rtjelum/m5dail_little_engineer/3d_models/renders/DeskBase.png

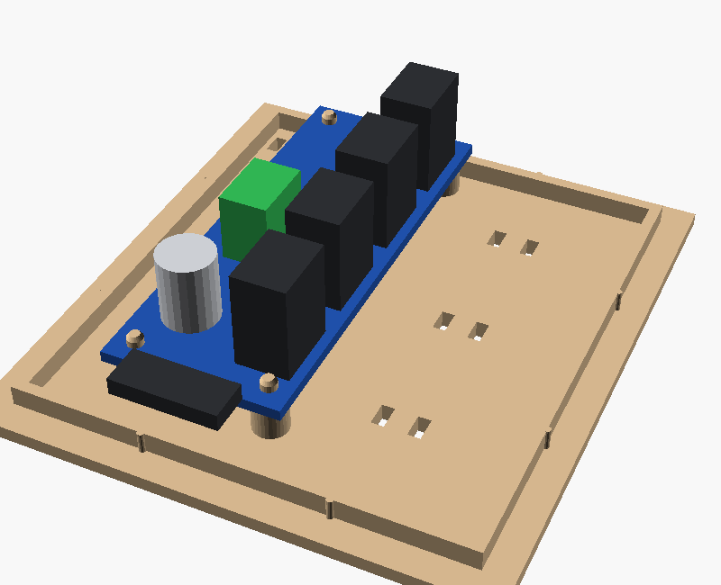
3d_models/renders/DeskBase.png
