rtjelum/m5dail_little_engineer/3d_models/renders/RobotScene_cutaway.png

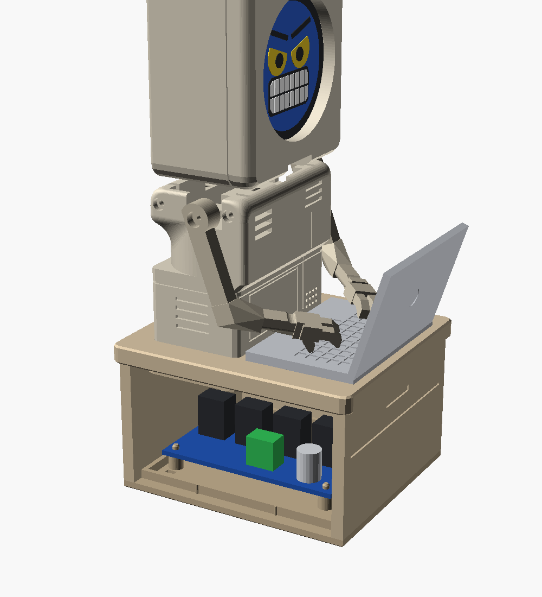
3d_models/renders/RobotScene_cutaway.png
