rtjelum/m5dail_little_engineer/3d_models/renders/RobotScene_side.png

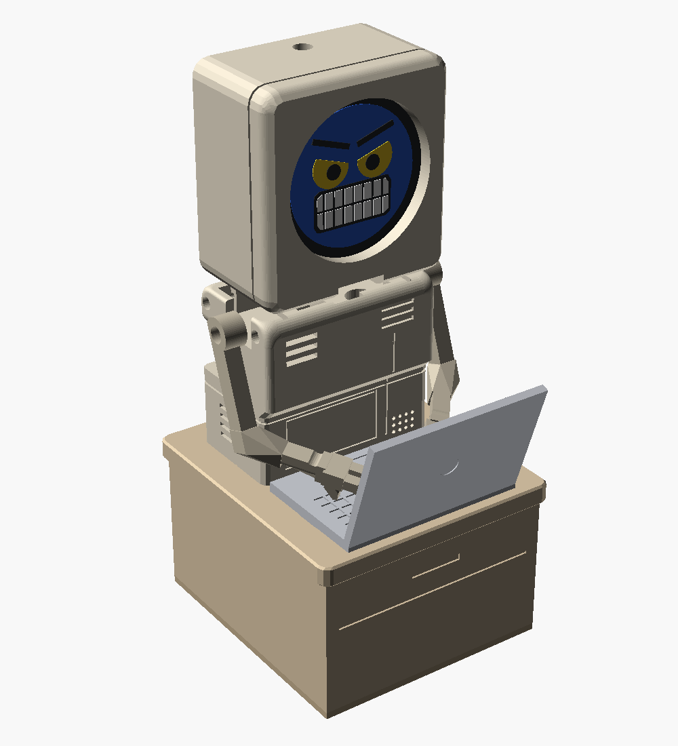
3d_models/renders/RobotScene_side.png
