rtjelum/m5dail_little_engineer/circular_maze.png

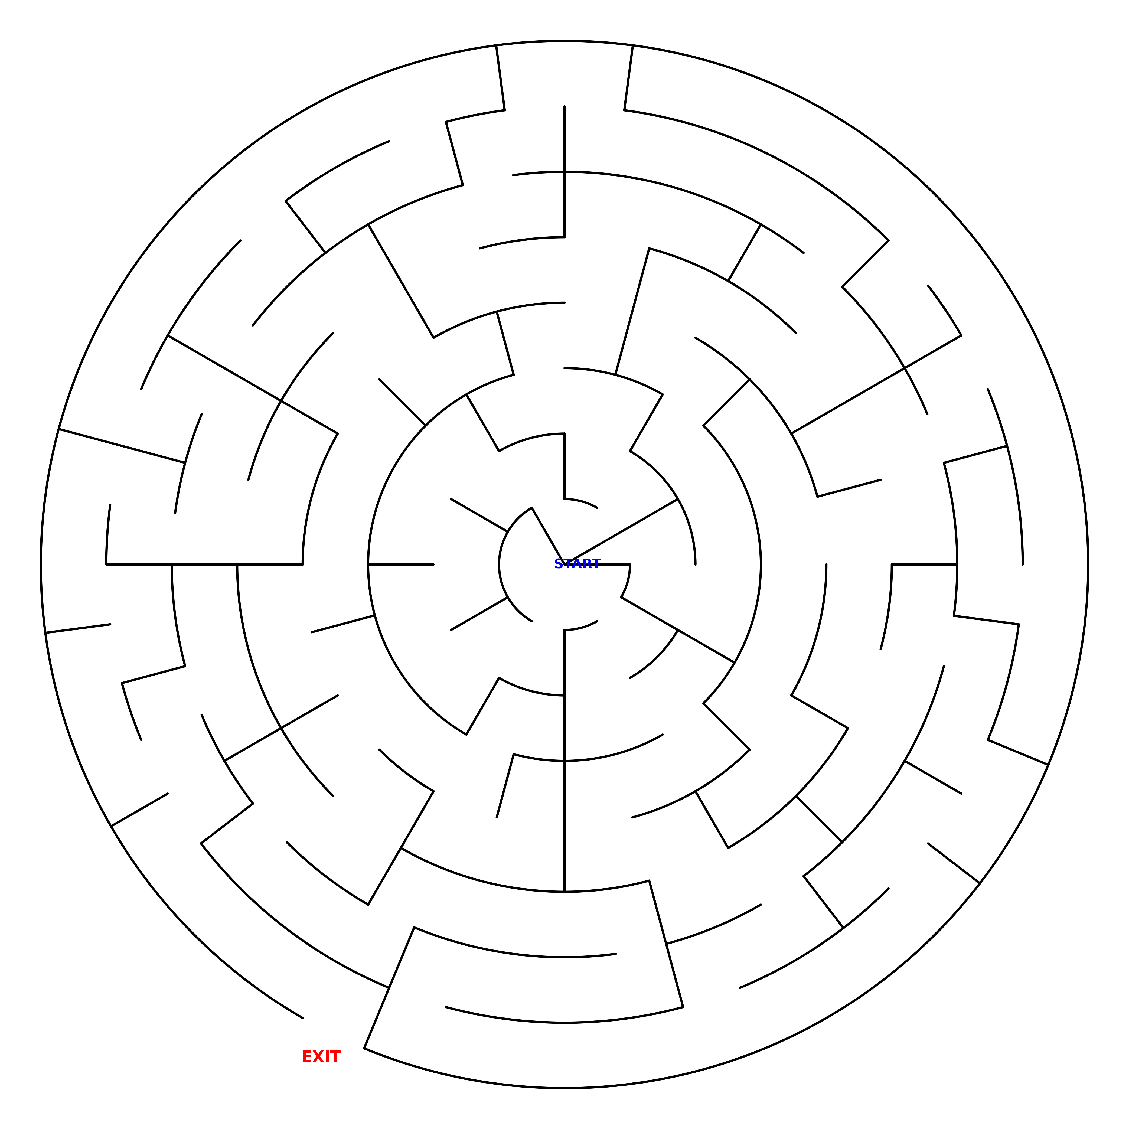
circular_maze.png
