rtjelum/m5dail_little_engineer/3d_models/openscad/base/es9051/LampCap.stl

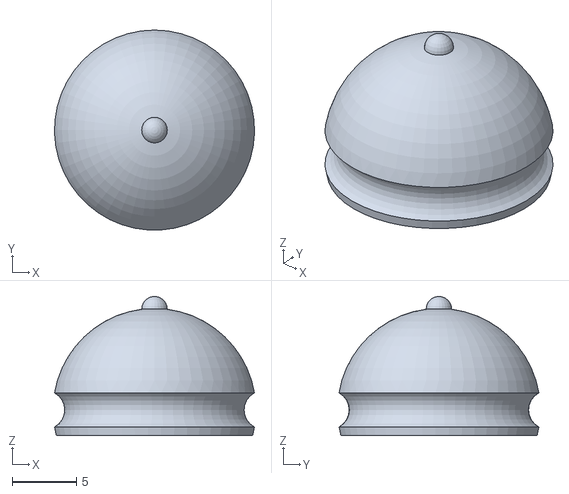
[picture p9: CAD file, 2026-11-06]
3d_models/openscad/base/es9051/LampCap.stl
15.6 x 15.6 x 10.9
