rtjelum/m5dail_little_engineer/3d_models/parts/gh-s37d/stl/DeskBox.stl

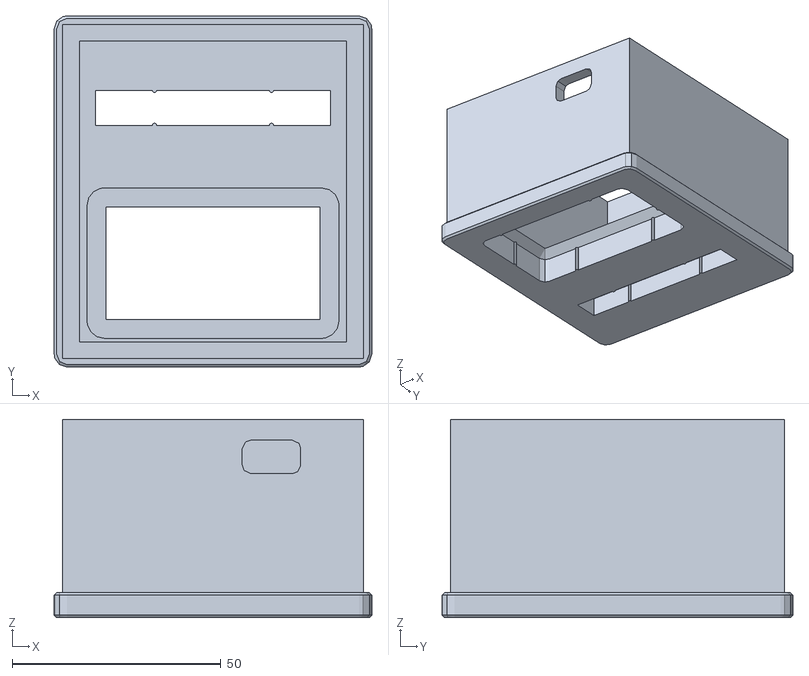
[picture p10: CAD file, 2026-11-10]
3d_models/parts/gh-s37d/stl/DeskBox.stl
76.0 x 84.0 x 47.5
