rtjelum/m5dail_little_engineer/3d_models/openscad/base/es9051/LaptopScreen.stl

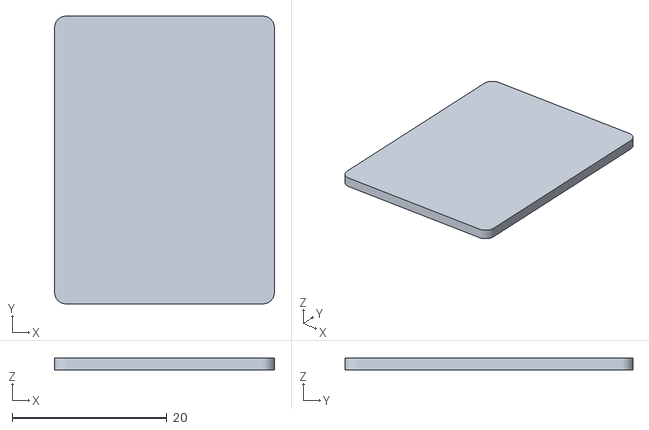
[picture p11: CAD file, 2026-11-06]
3d_models/openscad/base/es9051/LaptopScreen.stl
28.4 x 37.2 x 1.50
