rtjelum/m5dail_little_engineer/3d_models/parts/gh-s37d/stl/Torso.stl

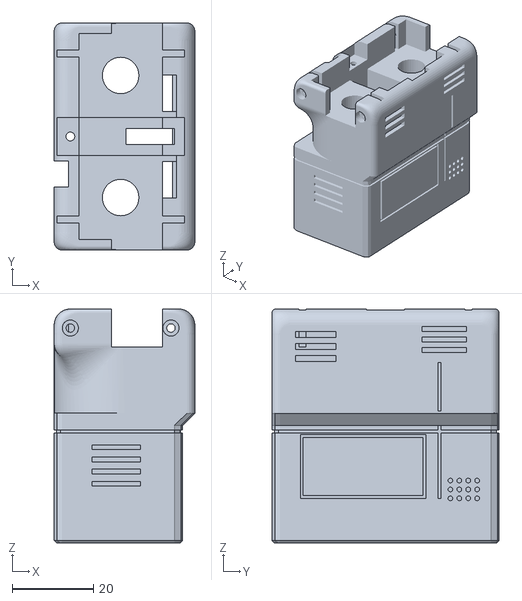
[picture p12: CAD file, 2026-11-10]
3d_models/parts/gh-s37d/stl/Torso.stl
34.7 x 56.0 x 57.7
