rtjelum/m5dail_little_engineer/3d_models/openscad/base/es9051/LaptopCase.stl

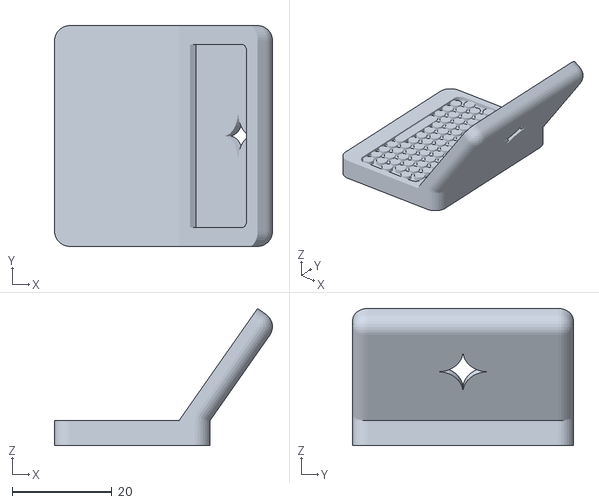
[picture p13: CAD file, 2026-11-06]
3d_models/openscad/base/es9051/LaptopCase.stl
43.8 x 44.4 x 27.5
