rtjelum/m5dail_little_engineer/3d_models/parts/gh-s37d/stl/DeskBase.stl

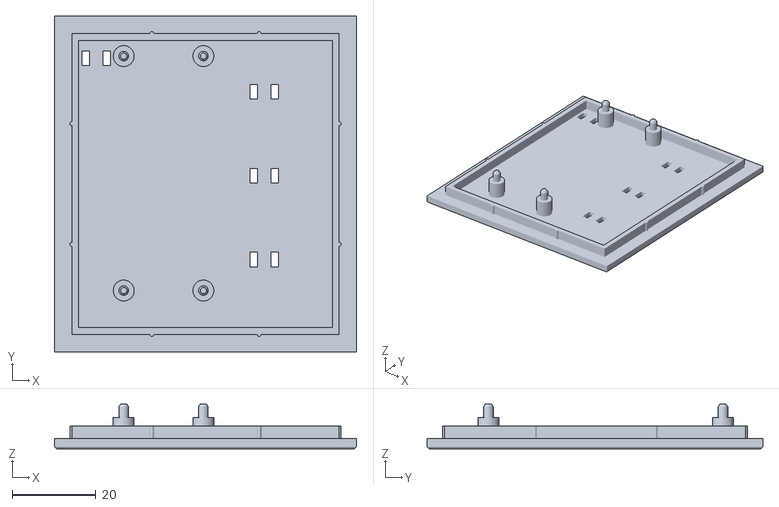
[picture p14: CAD file, 2026-11-10]
3d_models/parts/gh-s37d/stl/DeskBase.stl
72.0 x 80.0 x 10.7
