rtjelum/m5dail_little_engineer/3d_models/openscad/base/es9051/ForearmLeft.stl

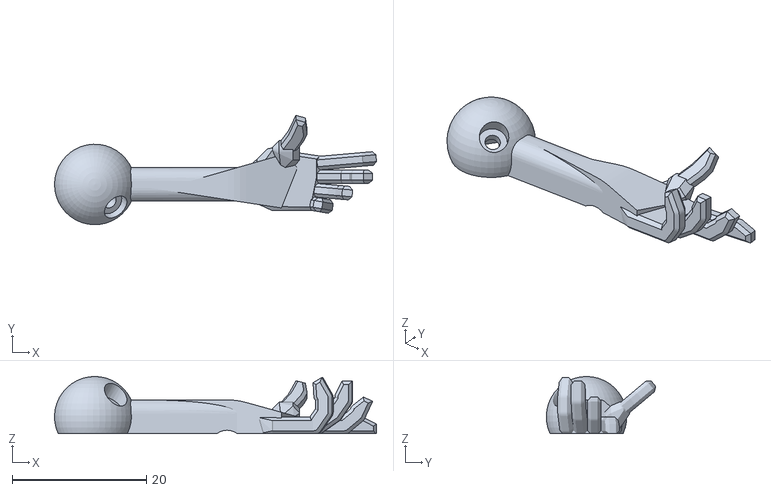
[picture p15: CAD file, 2026-11-06]
3d_models/openscad/base/es9051/ForearmLeft.stl
48.0 x 16.3 x 8.50
