rtjelum/m5dail_little_engineer/3d_models/parts/gh-s37d/stl/HeadM5Dial.stl

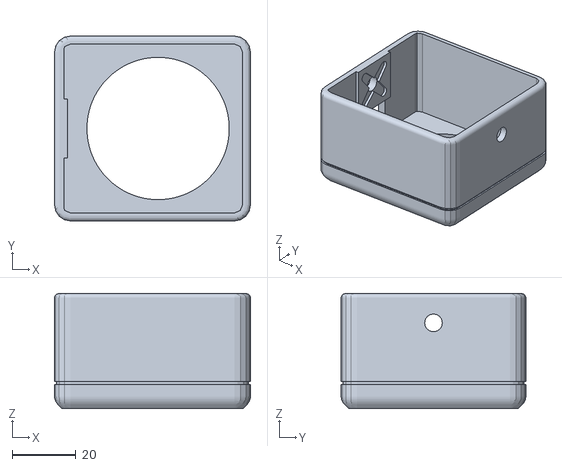
[picture p16: CAD file, 2026-11-10]
3d_models/parts/gh-s37d/stl/HeadM5Dial.stl
61.3 x 57.8 x 36.0
