rtjelum/m5dail_little_engineer/3d_models/openscad/base/es9051/BottomCover.stl

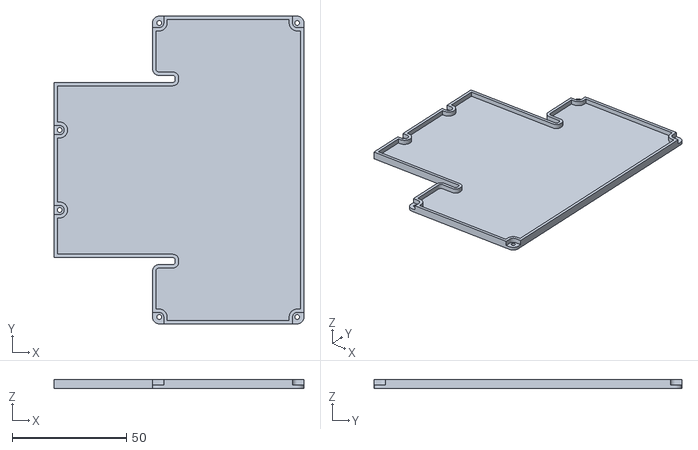
[picture p17: CAD file, 2026-11-06]
3d_models/openscad/base/es9051/BottomCover.stl
109.5 x 134.8 x 3.80
