rtjelum/m5dail_little_engineer/3d_models/parts/gh-s37d/stl/ArmLeft.stl

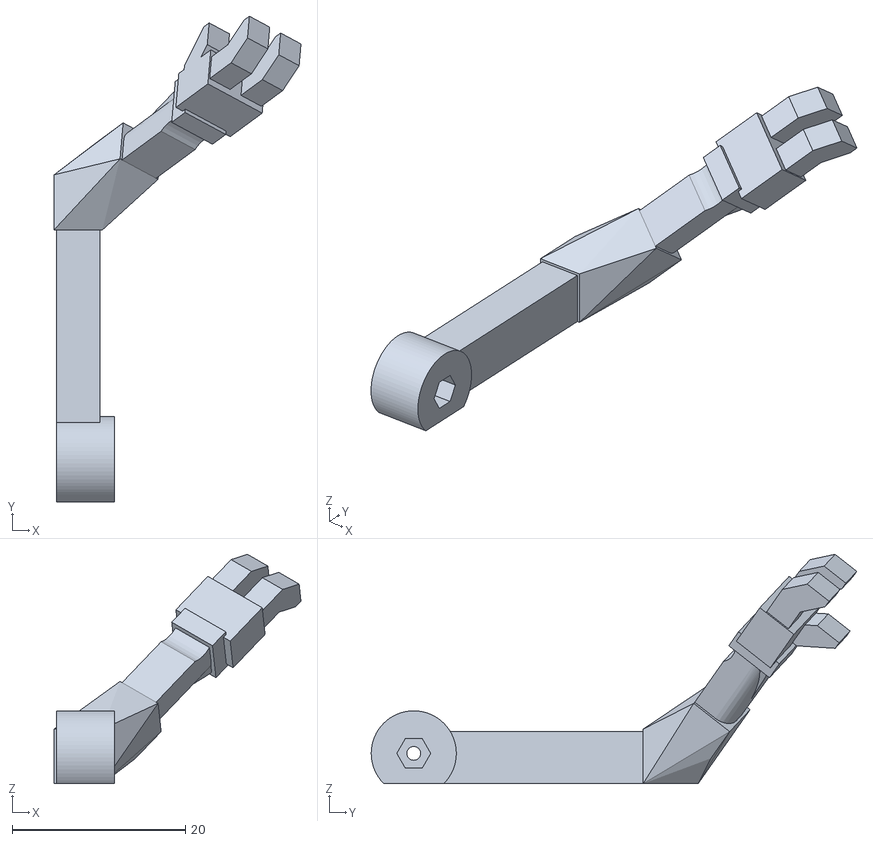
[picture p18: CAD file, 2026-11-10]
3d_models/parts/gh-s37d/stl/ArmLeft.stl
28.5 x 56.1 x 26.5
