rtjelum/m5dail_little_engineer/3d_models/openscad/base/es9051/Head.stl

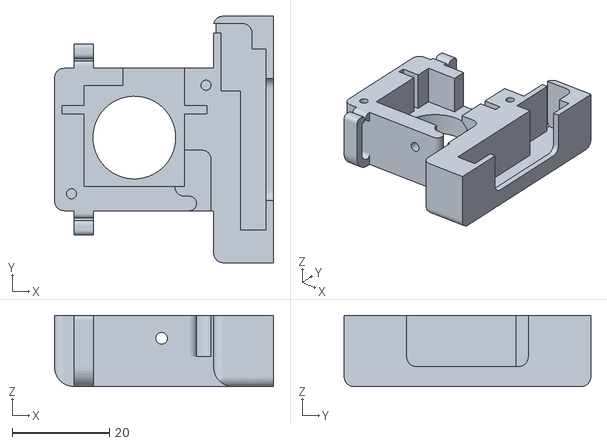
[picture p19: CAD file, 2026-11-06]
3d_models/openscad/base/es9051/Head.stl
45.0 x 50.7 x 14.6
