rtjelum/m5dail_little_engineer/3d_models/openscad/base/es9051/Hat.stl

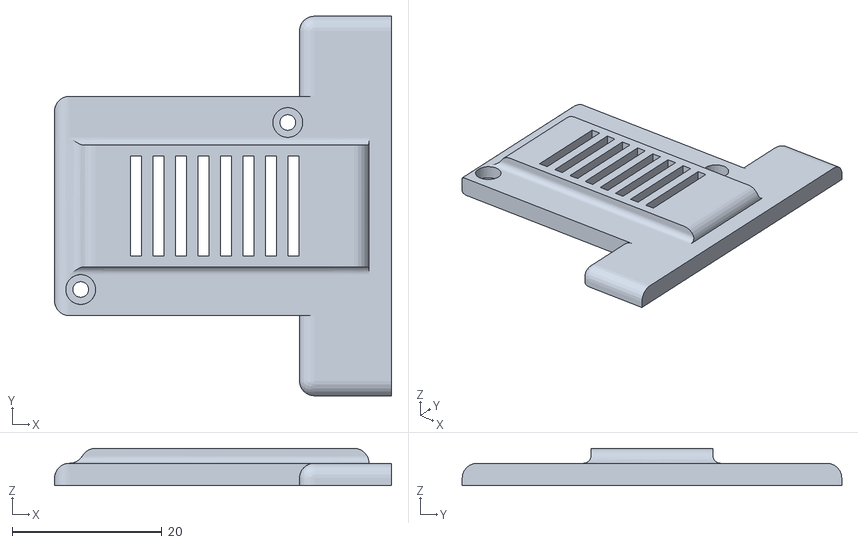
[picture p20: CAD file, 2026-11-06]
3d_models/openscad/base/es9051/Hat.stl
45.0 x 50.7 x 5.00
