rtjelum/m5dail_little_engineer/3d_models/parts/gh-s37d/stl/Laptop.stl

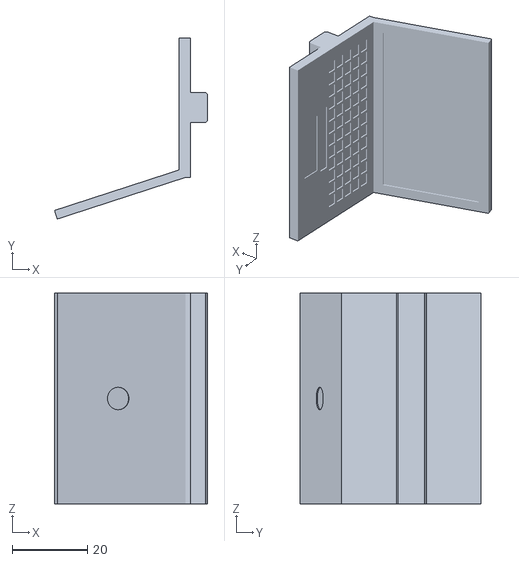
[picture p21: CAD file, 2026-11-10]
3d_models/parts/gh-s37d/stl/Laptop.stl
40.6 x 48.1 x 56.0
