rtjelum/m5dail_little_engineer/3d_models/openscad/base/es9051/Chair.stl

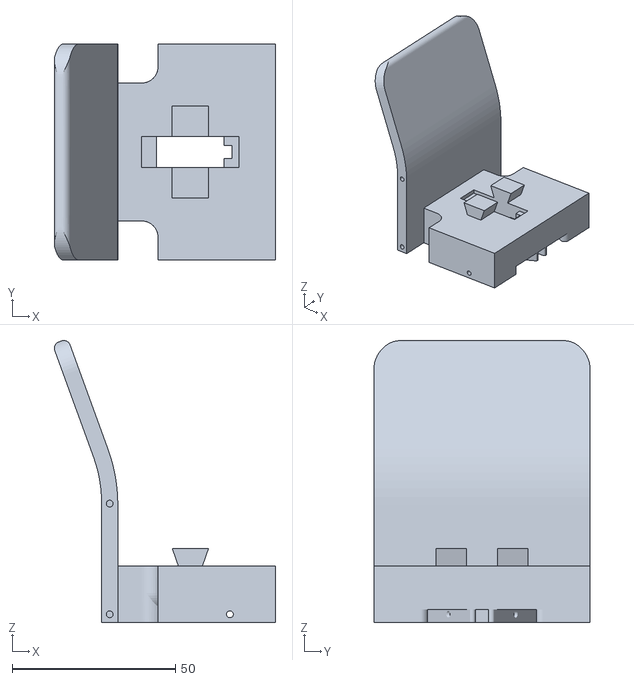
[picture p22: CAD file, 2026-11-06]
3d_models/openscad/base/es9051/Chair.stl
67.7 x 66.2 x 86.3
