rtjelum/m5dail_little_engineer/3d_models/parts/gh-s37d/stl/HeadSocketTest.stl

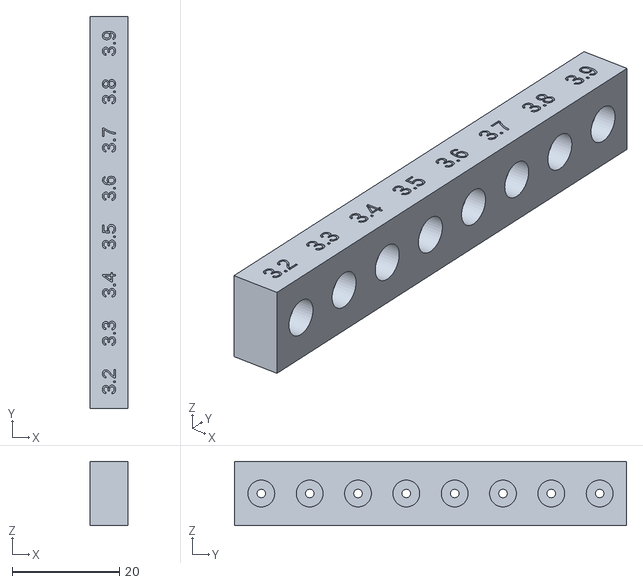
[picture p23: CAD file, 2026-11-06]
3d_models/parts/gh-s37d/stl/HeadSocketTest.stl
7.00 x 73.0 x 12.0
