rtjelum/m5dail_little_engineer/3d_models/openscad/base/es9051/UpperArm.stl

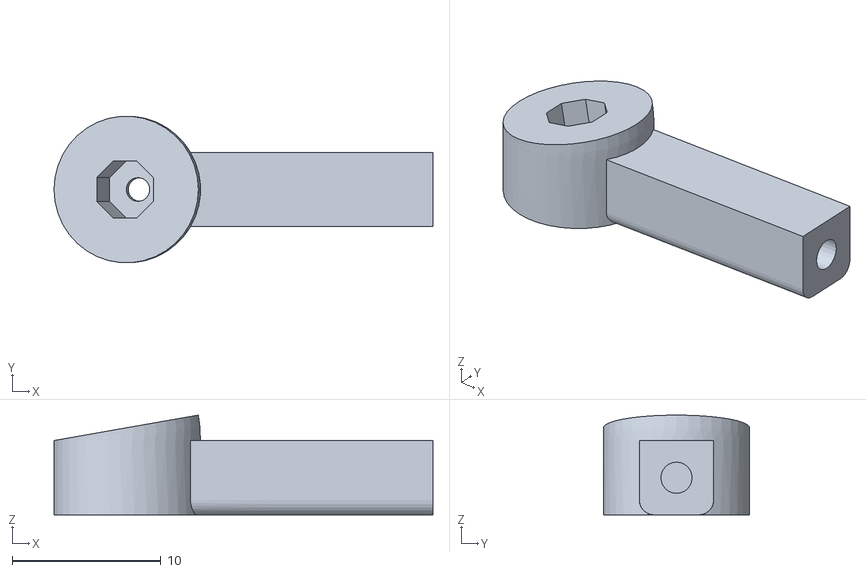
[picture p24: CAD file, 2026-11-06]
3d_models/openscad/base/es9051/UpperArm.stl
25.5 x 9.84 x 6.71
