rtjelum/m5dail_little_engineer/3d_models/openscad/base/es9051/LampDiffuser.stl

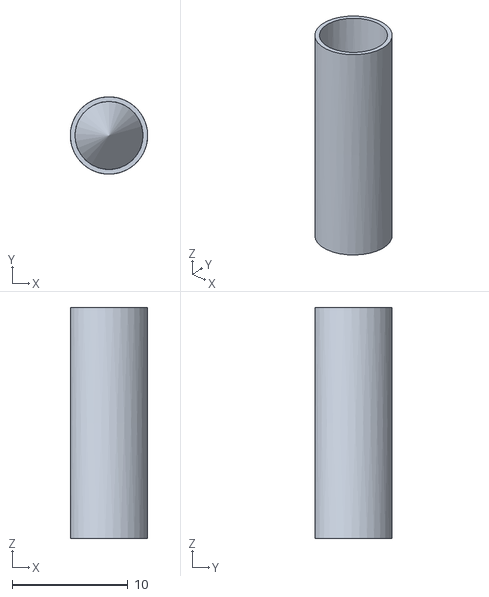
[picture p25: CAD file, 2026-11-06]
3d_models/openscad/base/es9051/LampDiffuser.stl
6.69 x 6.70 x 20.0
