rtjelum/m5dail_little_engineer/3d_models/openscad/base/es9051/BellyJoint.stl

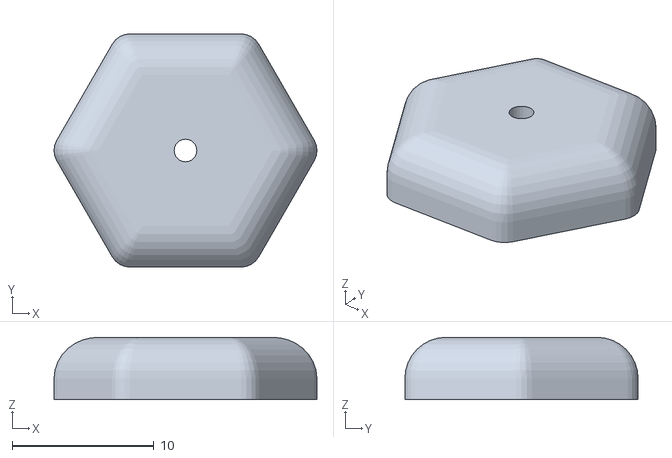
[picture p26: CAD file, 2026-11-06]
3d_models/openscad/base/es9051/BellyJoint.stl
18.6 x 16.5 x 4.40
