rtjelum/m5dail_little_engineer/3d_models/openscad/base/es9051/LampButton.stl

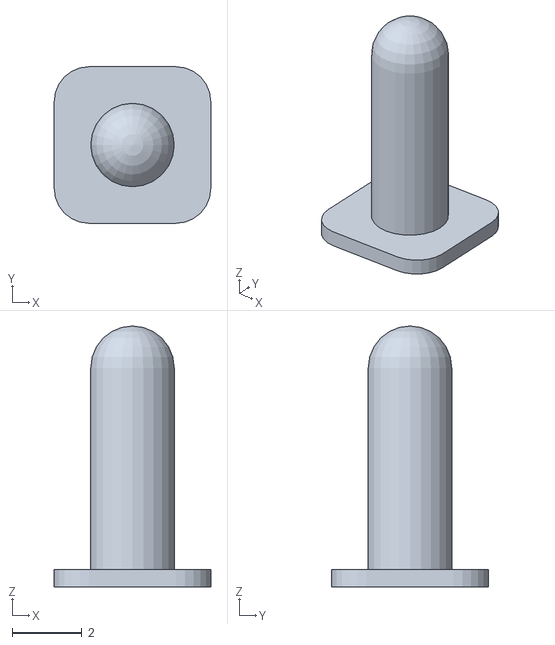
[picture p27: CAD file, 2026-11-06]
3d_models/openscad/base/es9051/LampButton.stl
4.50 x 4.50 x 7.50
