rtjelum/m5dail_little_engineer/3d_models/openscad/base/es9051/Bell.stl

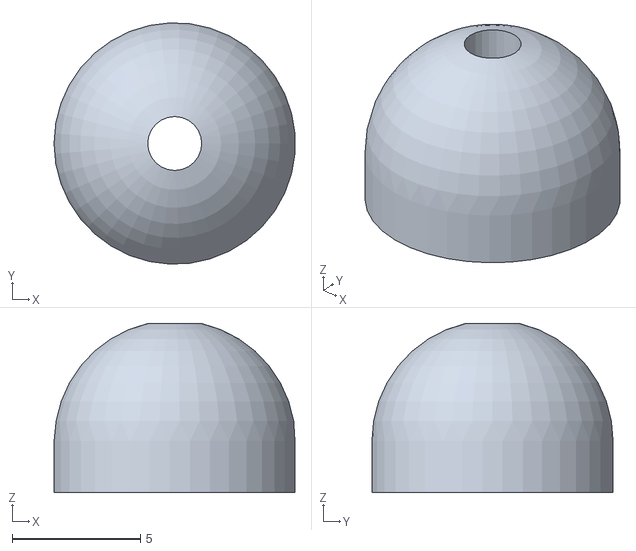
[picture p28: CAD file, 2026-11-06]
3d_models/openscad/base/es9051/Bell.stl
9.38 x 9.39 x 6.58
