rtjelum/m5dail_little_engineer/3d_models/openscad/base/es9051/SeatLeft.stl

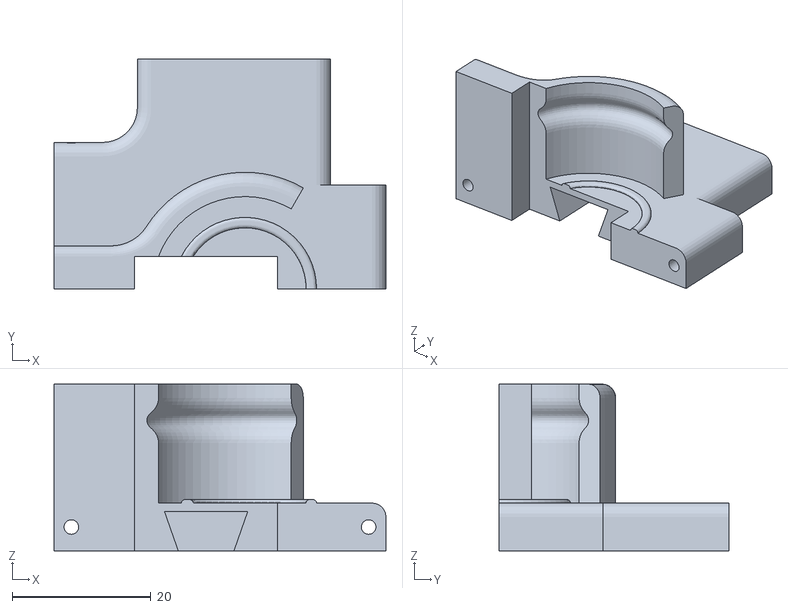
[picture p29: CAD file, 2026-11-06]
3d_models/openscad/base/es9051/SeatLeft.stl
47.8 x 33.1 x 24.0
