rtjelum/m5dail_little_engineer/3d_models/openscad/base/es9051/AiEmblem.stl

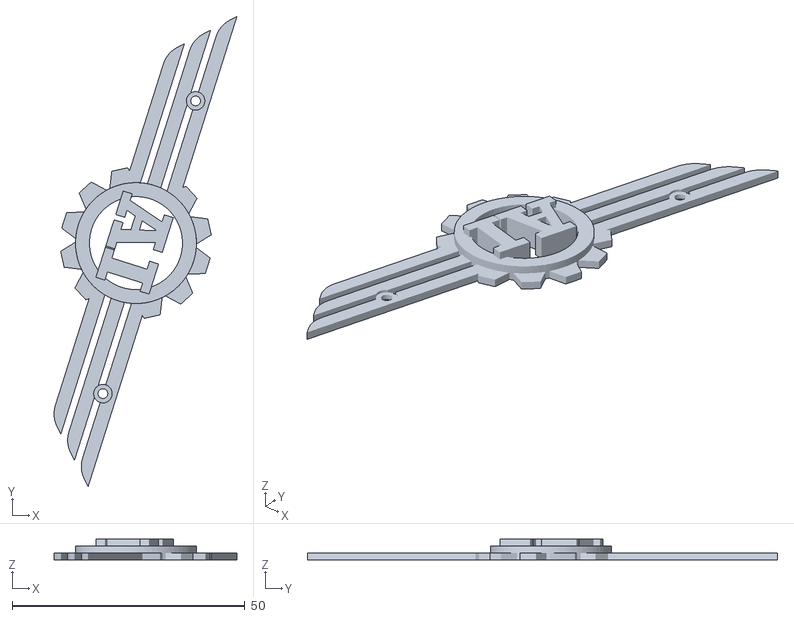
[picture p30: CAD file, 2026-11-06]
3d_models/openscad/base/es9051/AiEmblem.stl
39.3 x 101.1 x 4.50
