rtjelum/m5dail_little_engineer/3d_models/openscad/base/es9051/Neck.stl

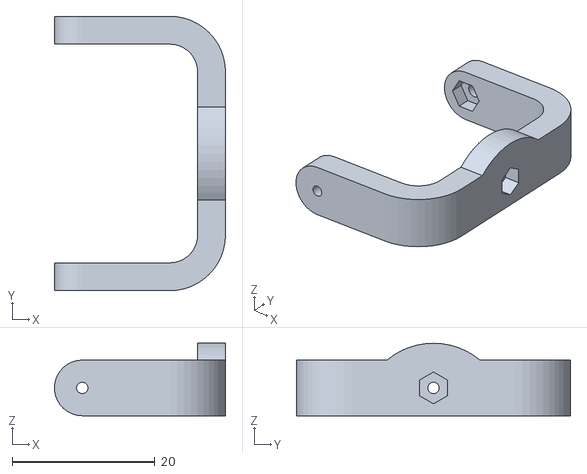
[picture p31: CAD file, 2026-11-06]
3d_models/openscad/base/es9051/Neck.stl
23.9 x 38.4 x 10.2
