rtjelum/m5dail_little_engineer/3d_models/openscad/base/es9051/LampBase.stl

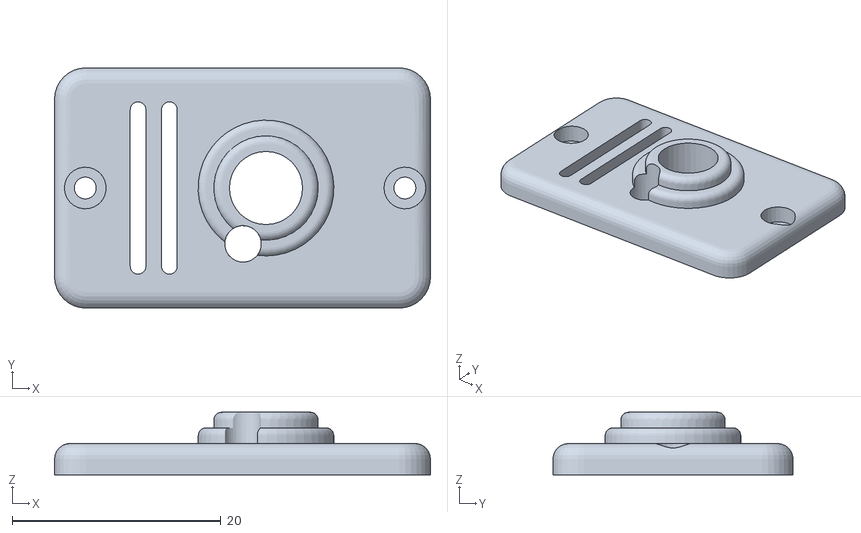
[picture p32: CAD file, 2026-11-06]
3d_models/openscad/base/es9051/LampBase.stl
36.0 x 23.0 x 6.00
