rtjelum/m5dail_little_engineer/3d_models/openscad/base/es9051/ServoSizingTester.stl

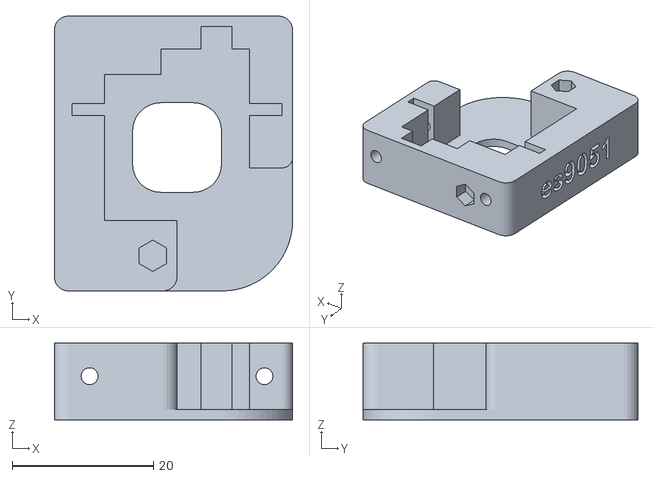
[picture p33: CAD file, 2026-11-06]
3d_models/openscad/base/es9051/ServoSizingTester.stl
33.8 x 39.0 x 10.9
