rtjelum/m5dail_little_engineer/3d_models/openscad/base/es9051/Chest.stl

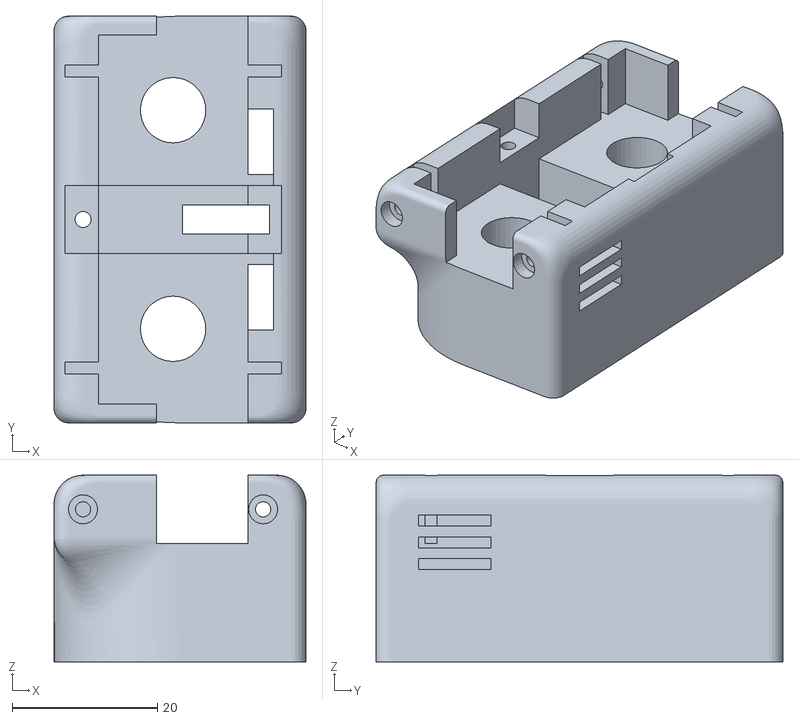
[picture p34: CAD file, 2026-11-06]
3d_models/openscad/base/es9051/Chest.stl
34.7 x 56.0 x 25.7
