rtjelum/m5dail_little_engineer/3d_models/openscad/base/es9051/DeskPad.stl

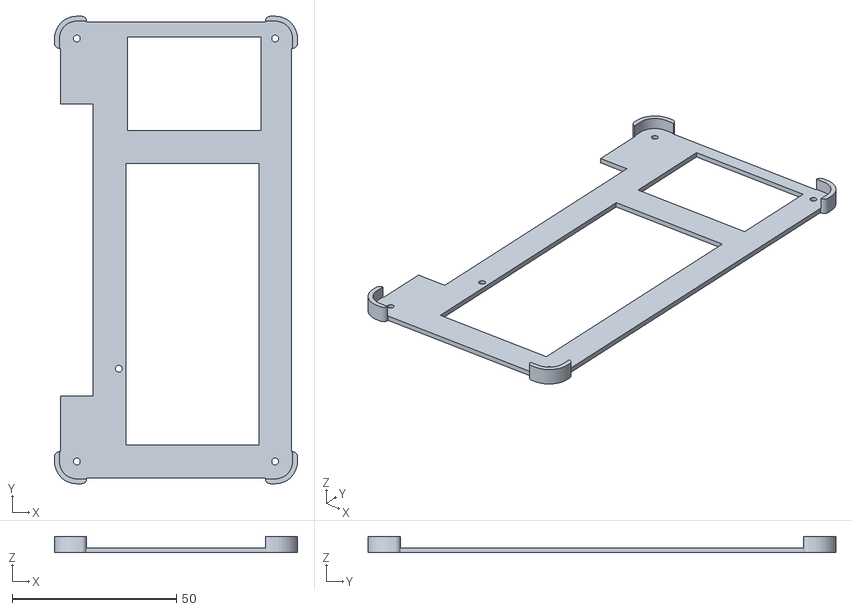
[picture p35: CAD file, 2026-11-06]
3d_models/openscad/base/es9051/DeskPad.stl
74.0 x 142.4 x 5.00
