rtjelum/m5dail_little_engineer/3d_models/openscad/base/es9051/Coffee.stl

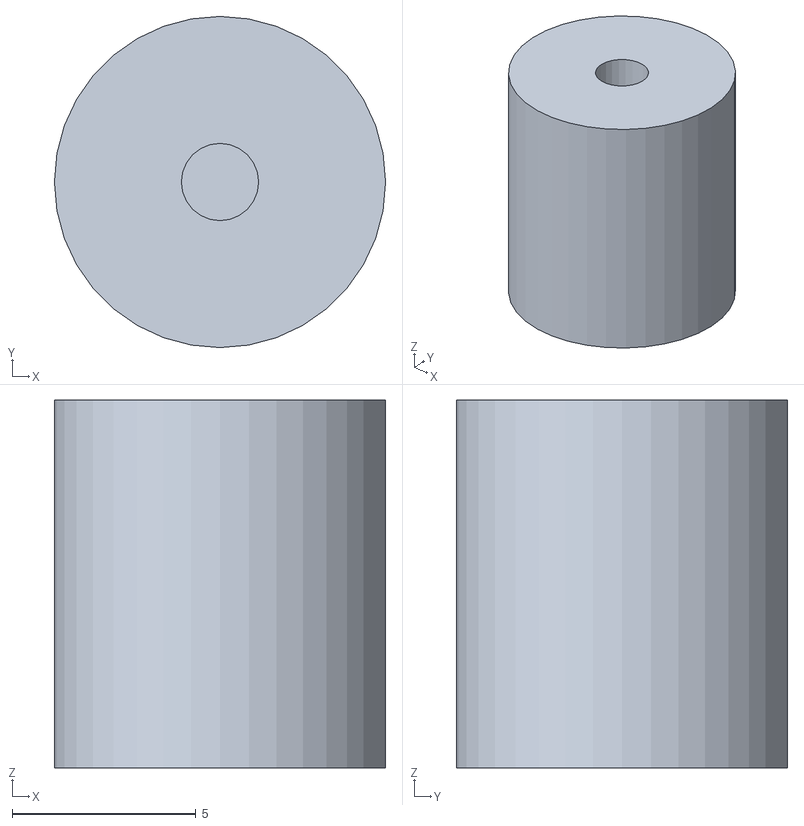
[picture p36: CAD file, 2026-11-06]
3d_models/openscad/base/es9051/Coffee.stl
9.00 x 9.00 x 10.00
