rtjelum/m5dail_little_engineer/3d_models/openscad/base/es9051/DeskTop.stl

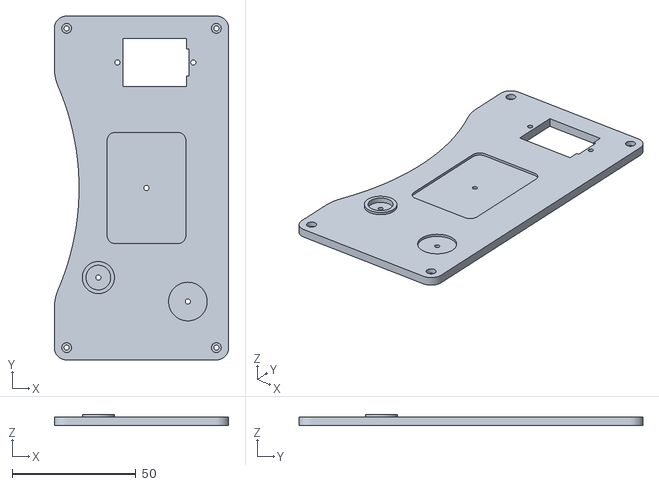
[picture p37: CAD file, 2026-11-06]
3d_models/openscad/base/es9051/DeskTop.stl
70.4 x 138.8 x 4.50
