rtjelum/m5dail_little_engineer/3d_models/openscad/base/es9051/Desk.stl

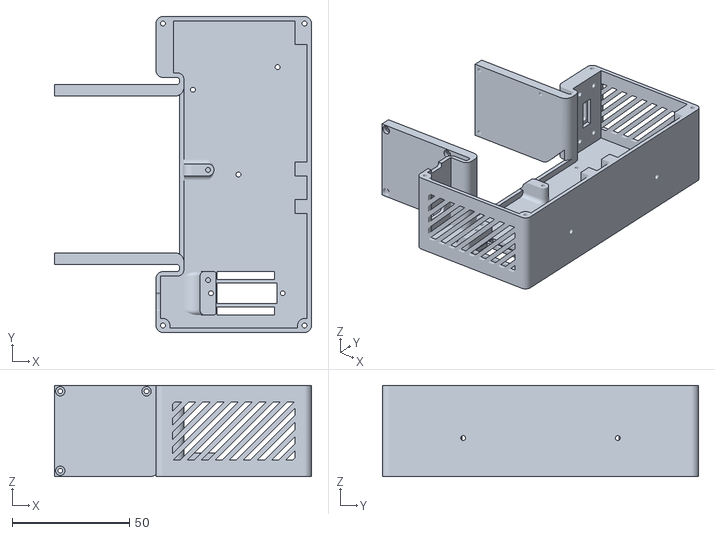
[picture p38: CAD file, 2026-11-06]
3d_models/openscad/base/es9051/Desk.stl
109.7 x 134.8 x 38.9
