rtjelum/m5dail_little_engineer/3d_models/openscad/base/es9051/Mug.stl

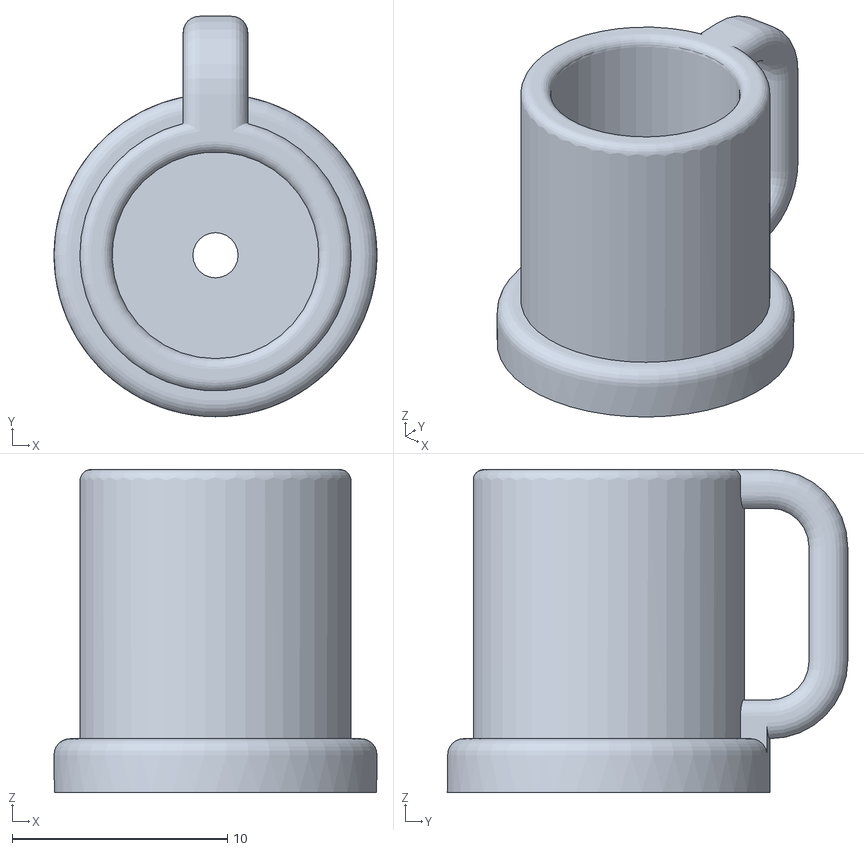
[picture p39: CAD file, 2026-11-06]
3d_models/openscad/base/es9051/Mug.stl
15.0 x 18.6 x 15.0
