rtjelum/m5dail_little_engineer/3d_models/openscad/ArmLeft.scad

// Left arm in one piece (UpperArm + ForearmLeft). See arm_onepiece.scad.
include <arm_onepiece.scad>

arm_left_print();
