rtjelum/m5dail_little_engineer/3d_models/openscad/DeskBase.scad

// Desk bottom plate, with pins for the PCA9685 and zip tie slots. See desk_parts.scad.
// Its rim presses up inside DeskBox. Print as exported, plate down.
include <desk_parts.scad>

desk_base();
