rtjelum/m5dail_little_engineer/(list of files, cad)

Other CAD files:
3d_models/parts/gh-s37d/stl/ArmRight.stl
3d_models/openscad/base/es9051/ForearmRight.stl
3d_models/openscad/base/es9051/SeatRight.stl
3d_models/openscad/base/es9051/ScrewSizingTest.stl
