rtjelum/m5dail_little_engineer/(commit log)

2026-11-04 M5Dial project: dial gauge, RFID, circular maze, PCA9685 two-servo control
2026-11-05 Add animated faces and sounds, controlled over serial
    - faces.h: 10 animated expressions in two styles (big glowing eyes,
    and a "bot" style with yellow eyes, teeth grid and LED-dot look).
    Blinking, glances, per-expression motion, animated wink, and a
    reading-eyes "thinking" face. Bot thinking face shows at power-on.
    - sounds.h: non-blocking notification sounds (done, question, error,
    ...) plus a procedural typing sound with variable speed.
    - face.sh: send face/sound commands from the shell, e.g.
    ./face.sh bot happy, ./face.sh sound done
    - Removed the beep on face change.
    [faces.h, m5dail_proj.ino, sounds.h]
2026-11-06 Add 3D models for GH-S37D servos and an M5Dial head
    - Tiny Engineer CAD and Fusion add-in with a GH-S37D preset
    - OpenSCAD sources and STLs adapted from the ES9051 parts:
    tab slots widened for the GH-S37D in Chest, Chair and tester
    - Fixed M5Dial head mounted on the neck servo's cross horn,
    with a USB-C slot in the floor
    - One-piece left/right arms with a 3.4 mm hex shoulder socket
    - Test prints: face plate, horn mount, shaft sockets, neck stand
    [AiEmblem.stl, ArmLeft.scad, ArmLeft.stl, ArmRight.scad, ArmRight.stl, Bell.stl, Belly.stl, BellyJoint.stl]
2026-11-06 Add third servo, servo speed control and default angles
    - Support 3 servos (PCA9685 channels 0-2), dial tap cycles all three.
    - "servo <n> <deg> [deg/s]" moves smoothly at the given speed;
    without a speed it jumps as before.
    - Default angles 40/100/130 deg at power-on and on "reset".
    - Faces stay up: messages show for 3 s then the face returns, echoed
    replies are ignored, and leaving face mode needs a button hold.
    - "rotate <0-3>" serial command (DISPLAY_ROTATION sets power-on, 0).
    - face.sh passes servo and rotate commands through and configures
    the port while open so replies aren't echoed back.
    [m5dail_proj.ino]
2026-11-10 Redesign the robot after improve_robot.jpg
    - Torso: the Chest's servo block on a boxy lower body with a 45-degree
    front step, replacing Chest, Belly, BellyJoint, Bell, BottomCover and Chair
    - HeadM5Dial: rounded edges and a seam groove
    - One-piece arms: square elbow, simple robot claws, and a 12 mm longer
    upper arm so the claws reach the laptop keys and clear its screen
    - Desk: DeskBox with a socket for the torso and a slot for the laptop,
    and a DeskBase bottom plate that holds the PCA9685 and the wiring
    - Laptop prop that slots into the desk top
    - RobotScene.scad display scene and renders
    - Remove parts, tests and Fusion files the new robot doesn't use;
    keep HeadSocketTest
    Co-Autho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
    [AiEmblem.stl, ArmLeft.stl, ArmRight.stl, Bell.stl, Belly.stl, BellyJoint.stl, BottomCover.stl, Chair.scad]
2026-11-10 Add typing arms, downward reading gaze and PWM frequency command
    - Thinking face (both styles) looks down, reading a laptop screen
    - "arms thinking [deg/s] [min s] [max s]" / "arms off": random eased
    keystrokes on servos 1 and 3, random pauses, occasional servo 3 lift
    - "pwm <Hz>" sets the PCA9685 frequency; finer pulse rounding
    - face.sh passes arms, pwm and reset through; README updated
    [faces.h, m5dail_proj.ino]
2026-11-10 Remove references to deleted image and PDF files
    [HeadM5Dial.scad, arm_onepiece.scad, torso_body.scad]
2026-11-10 Lower arm typing angles, add random head turns, arm speed 100
    - Servo 1 types 135<->145 deg, servo 3 types 40<->30 deg
    - Head (servo 2) turns to a random 85-95 deg every 2-10 s at 40 deg/s
    - Default arm speed 100 deg/s
2026-11-10 Add thinking, done, question and sleep animations
    - done: cartoon "job done" face, done bell, servo 1 at 120°, servo 3 waves 80/90° every 2 s
    - question: cartoon "?" face, question sound, servo 1 rocks 90° (100 deg/s) / 110° (30 deg/s) with a 1 s pause
    - thinking: thinking face + typing arms in one command
    - sleep: eyes sleeping face + arms off
    - Head no longer turns while typing (HEAD_TURNS = false)
    [faces.h, m5dail_proj.ino, sounds.h]
2026-11-11 Add BLE command interface, case-insensitive commands, better help/status
    - BLE GATT service (M5Dial-Robot) with one characteristic for write
    (commands), notify (live output) and read (output of the last command)
    - All console output goes to USB serial and connected BLE clients
    - Commands match regardless of case; free text keeps its case
    - help lists commands, help <command> shows details and examples
    - status shows mode, servo angles, arms, sound, BLE, RFID, uptime, build
    - ble_monitor.py: two-way BLE terminal (bleak)
